rmaguire31/l3-pcb-assignment/tex/img/audio_amplifier_sch.png

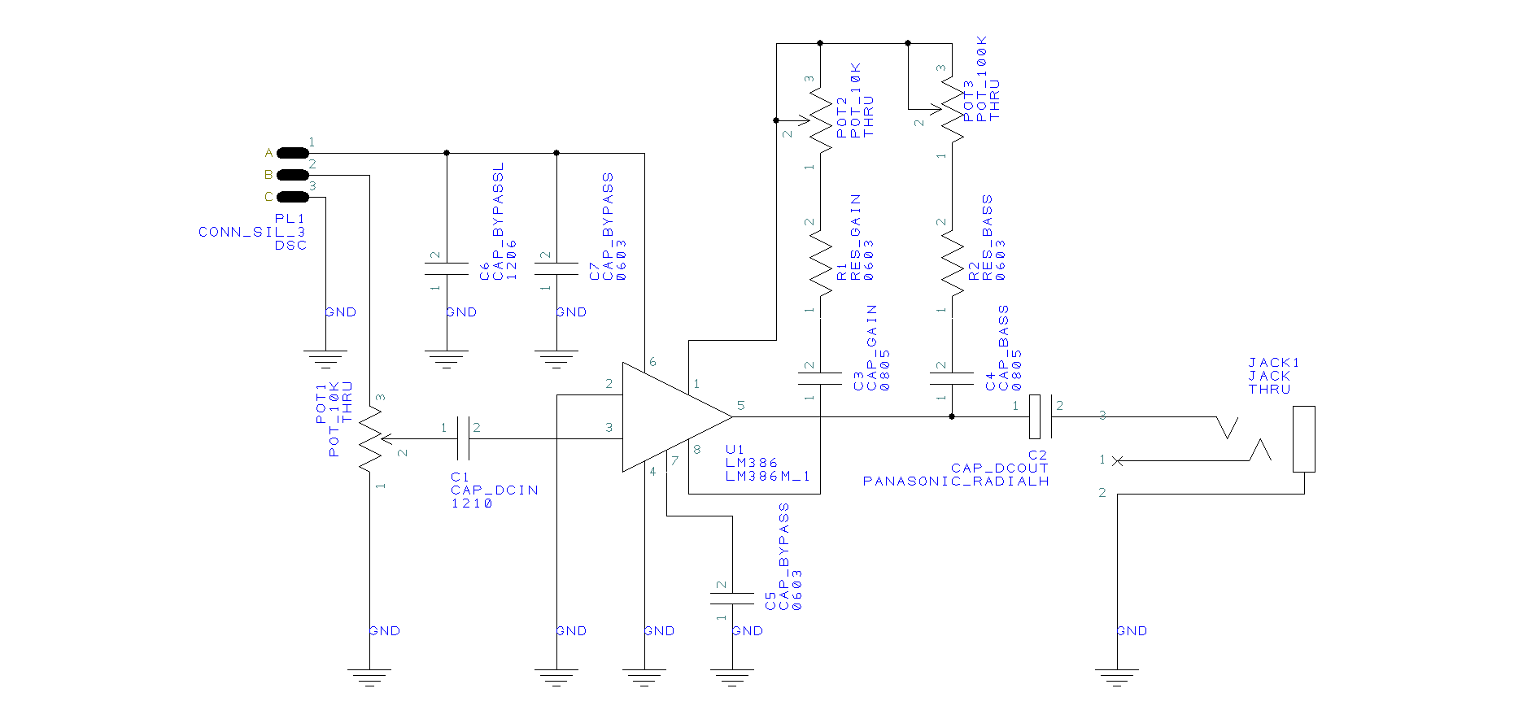
tex/img/audio_amplifier_sch.png
