rmaguire31/l3-pcb-assignment/tex/img/spice_trans.pdf

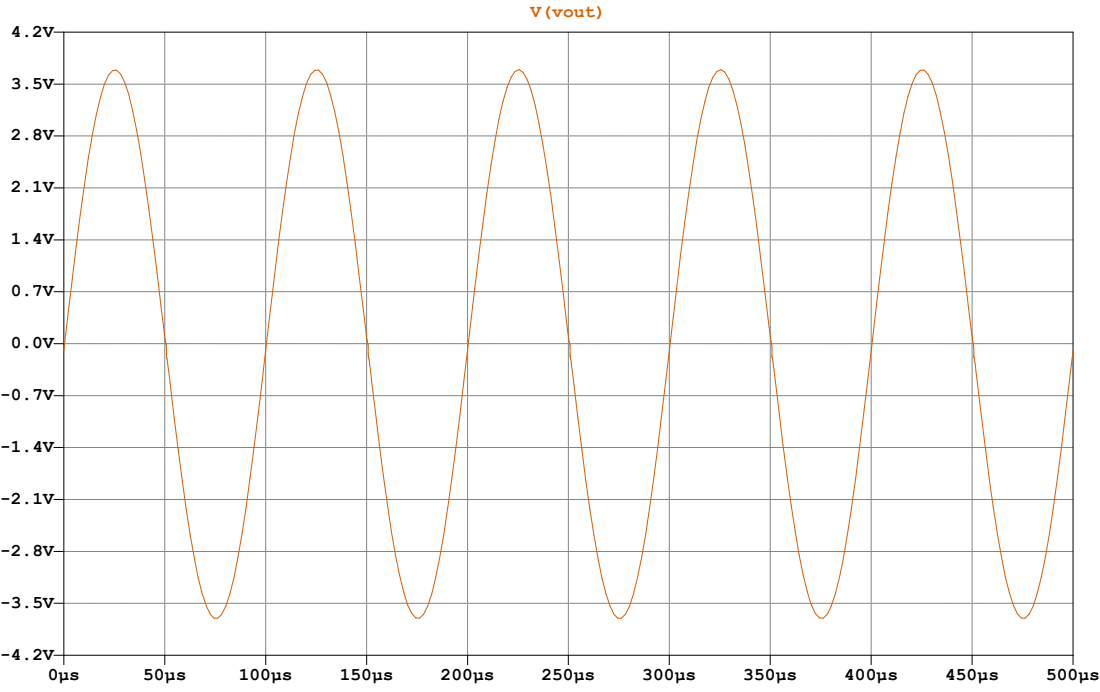
[picture p11: page 1]
V(vout)

--- C:\Users\rmagu\Repos\l3-pcb-assignment\spice\audio_amplifier.raw ---
