rmaguire31/l3-pcb-assignment/tex/img/spice_vol.pdf

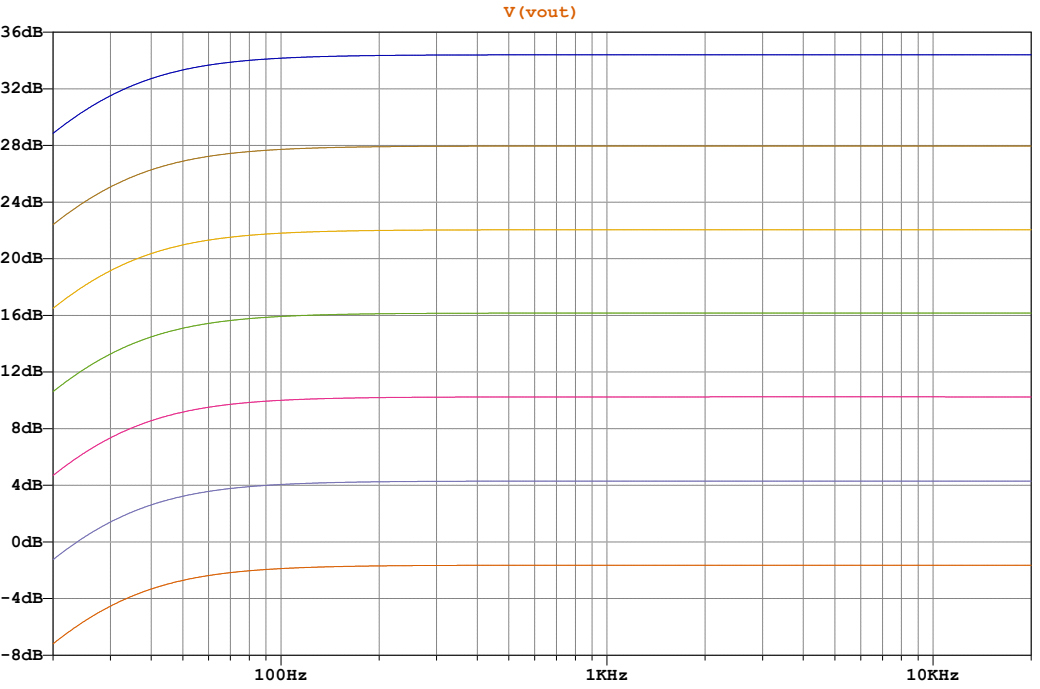
[picture p12: page 1]
1KHz; 10KHz; V(vout)

--- C:\Users\rmagu\Repos\l3-pcb-assignment\spice\audio_amplifier.asc ---
