rmaguire31/l3-pcb-assignment/tex/img/spice_circuit.pdf

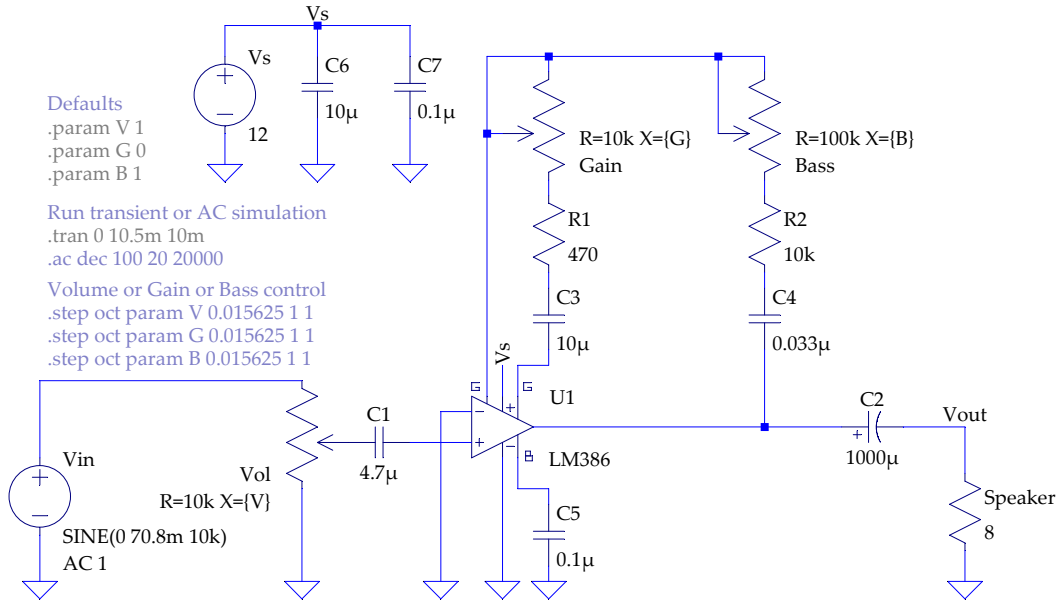
[picture p13: page 1]

Defaults
.param V 1
.param G 0
.param B 1
Run transient or AC simulation
.tran 0 10.5m 10m
.ac dec 100 20 20000
Volume or Gain or Bass control
.step oct param V 0.015625 1 1
.step oct param G 0.015625 1 1
.step oct param B 0.015625 1 1
