rmaguire31/l3-pcb-assignment/tex/img/audio_amplifier_sch.pdf

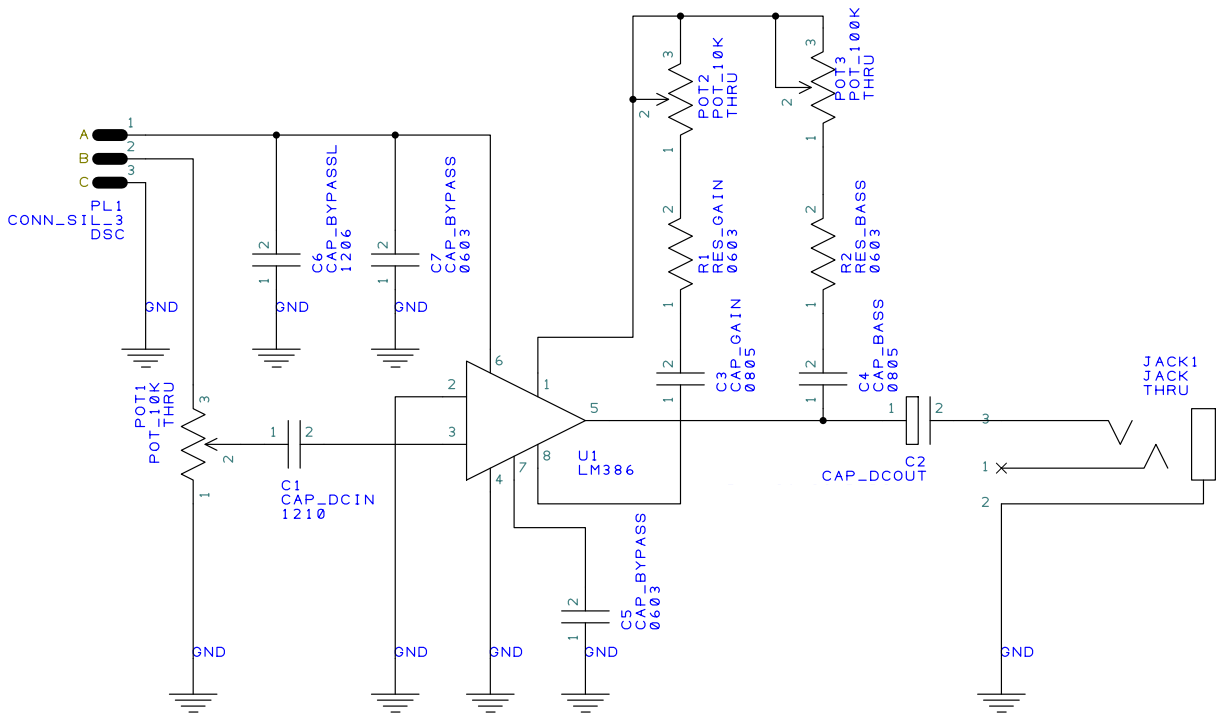
[picture p14: page 1]
