rmaguire31/l3-pcb-assignment/tex/img/audio_amplifier_pcb.pdf

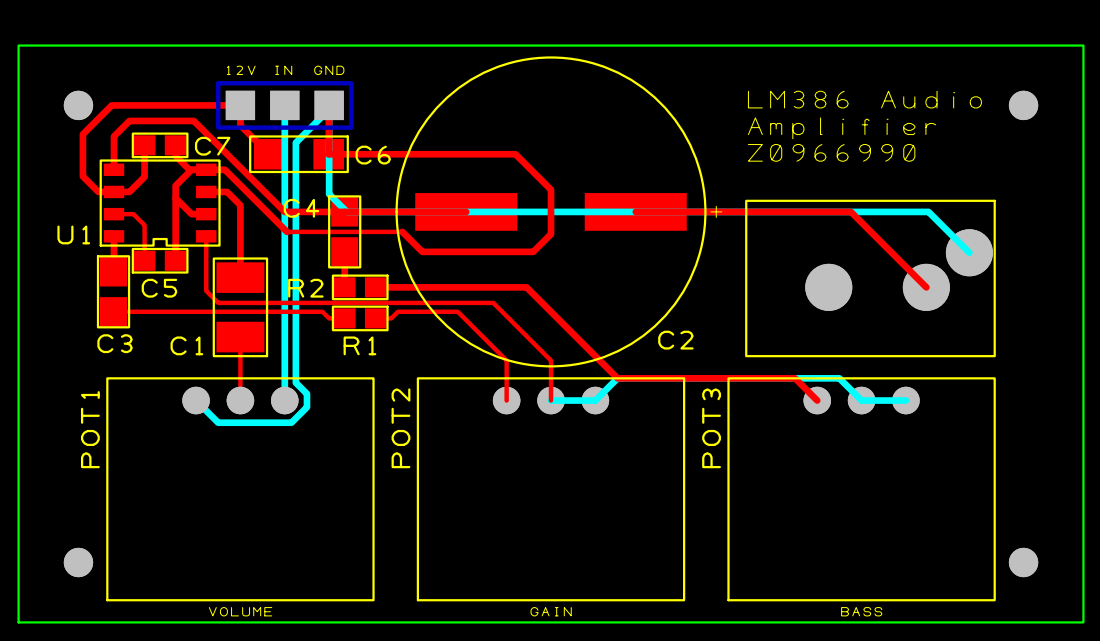
[picture p15: page 1]
