rmaguire31/l3-pcb-assignment/audio_amplifier.asc

Bass: pot; R=100k X={B}
C1: cap; 4.7µ; V=25 Rser=7 Lser=1020p
C2: polcap; 2200µ; V=25 Irms=1.8 Rser=70m
C3: cap; 10µ; V=25 Rser=1 Lser=1050p
C4: cap; 0.033µ; V=25 Rser=30 Lser=1050p
C5: cap; 0.1µ; V=25 Rser=35 Lser=850p
C6: cap; 10µ; V=25 Irms=0 Rser=1 Lser=1250p
C7: cap; 0.1µ; V=25 Irms=0 Rser=35 Lser=850p
Gain: pot; R=10k X={G}
R1: res; 470; tol=5 pwr=63m
R2: res; 10k; tol=5 pwr=63mW
Speaker: res; 8
U1: LM386
Vin: voltage; SINE(0 70.8m 10k); AC 1
Vol: pot; R=10k X={V}
Vs: voltage; 12
Named nets: 0, Vs, Vout
.param V 1
.step oct param B 0.015625 1 1
.param B 1
.param G 0
.step oct param G 0.015625 1 1
.tran 0 1m
Run transient or AC simulation
Defaults
.ac dec 100 20 20000
.step oct param V 0.015625 1 1
Volume or Gain or Bass control
