rmaguire31/l3-pcb-assignment/spice/audio_amplifier.asc

Bass: pot; R=100k X={B}
C1: cap; 4.7µ; V=25
C2: polcap; 1000µ; V=25
C3: cap; 10µ; V=25
C4: cap; 0.033µ; V=25
C5: cap; 0.1µ; V=25
C6: cap; 10µ; V=25
C7: cap; 0.1µ; V=25
Gain: pot; R=10k X={G}
R1: res; 470; tol=5 pwr=63m
R2: res; 10k; tol=5 pwr=63mW
Speaker: res; 8
U1: LM386
Vin: voltage; SINE(0 70.8m 10k); AC 1
Vol: pot; R=10k X={V}
Vs: voltage; 12
Named nets: 0, Vs, Vout
.param V 1
.step oct param B 0.015625 1 1
.param B 1
.param G 0
.step oct param G 0.015625 1 1
.tran 0 10.5m 10m
Run transient or AC simulation
Defaults
.ac dec 100 20 20000
.step oct param V 0.015625 1 1
Volume or Gain or Bass control
