rmaguire31/l3-pcb-assignment/spice/pot.asc

R1: res; {Ra}; tol=20 pwr=500m
R2: res; {Rb}; tol=20 pwr=500m
Named nets: 1, 2, 3
.param Ra=2+R*X
.param Rb=2+R*(1-X)
