rmaguire31/l3-pcb-assignment/(list of files, drawings)

Other design files:
pcb/audio_amplifier.pcb
