rmaguire31/l3-pcb-assignment/(commit log)

2017-11-30 Added input decoupling capacitor to audio amplifier
2017-12-03 Finished circuit topology. Need to select capacitors
2017-12-04 Schematic release candidate
2017-12-05 Added designspark components and schematic
    [audio_amplifier.sch]
2017-12-05 Initial PCB commit
    [audio_amplifier.sch]
2017-12-05 Added PCB
    [audio_amplifier.pcb]
2017-12-06 Finished PCB layout
    [audio_amplifier.pcb, audio_amplifier.sch]
2017-12-07 Final PCB layout
    [audio_amplifier.pcb]
2017-12-07 Made board narrower
    [audio_amplifier.pcb]
2017-12-07 New bitmap and PCB adjusted again
    [audio_amplifier.pcb]
2017-12-07 Include 1000u CAP_DCOUT, modified PDF
    [audio_amplifier.pcb, audio_amplifier.sch]
